Quilliams85/FluidBedRoaster/Documentation/Photos/IMG_2953 Large.jpeg

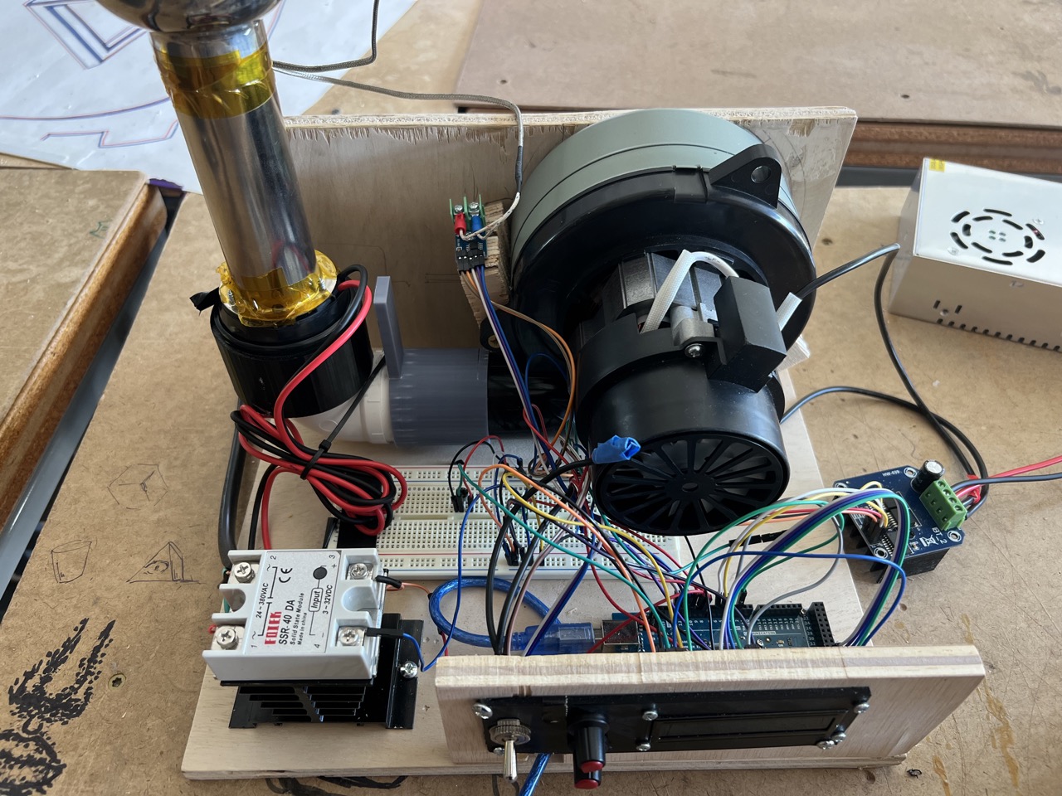
Documentation/Photos/IMG_2953 Large.jpeg
