Quilliams85/FluidBedRoaster/Documentation/Photos/IMG_2955 Large.jpeg

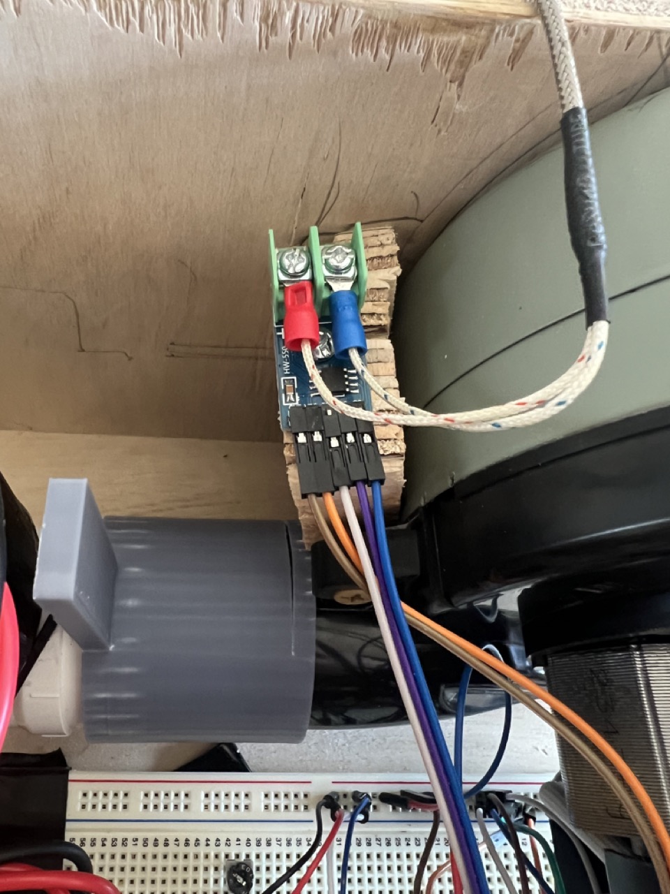
Documentation/Photos/IMG_2955 Large.jpeg
