Quilliams85/FluidBedRoaster/Documentation/Photos/IMG_2956 Large.jpeg

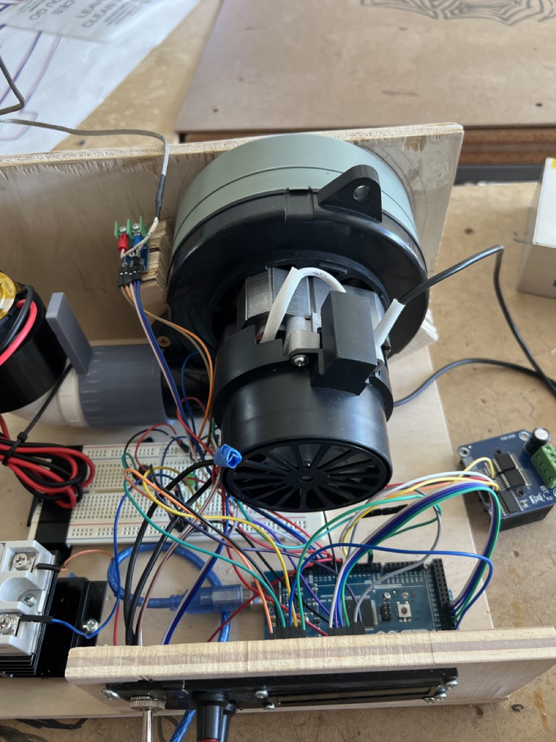
Documentation/Photos/IMG_2956 Large.jpeg
