Quilliams85/FluidBedRoaster/Documentation/Photos/IMG_2957 Large.jpeg

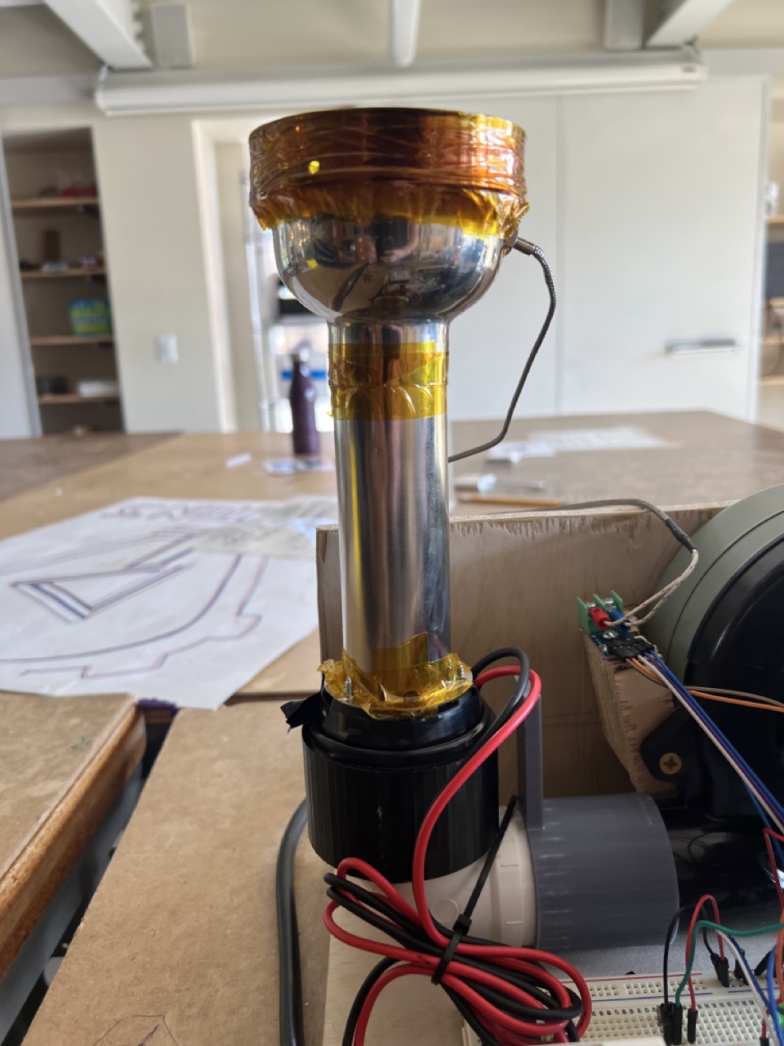
Documentation/Photos/IMG_2957 Large.jpeg
