Quilliams85/FluidBedRoaster/Documentation/Photos/IMG_2958 Large.jpeg

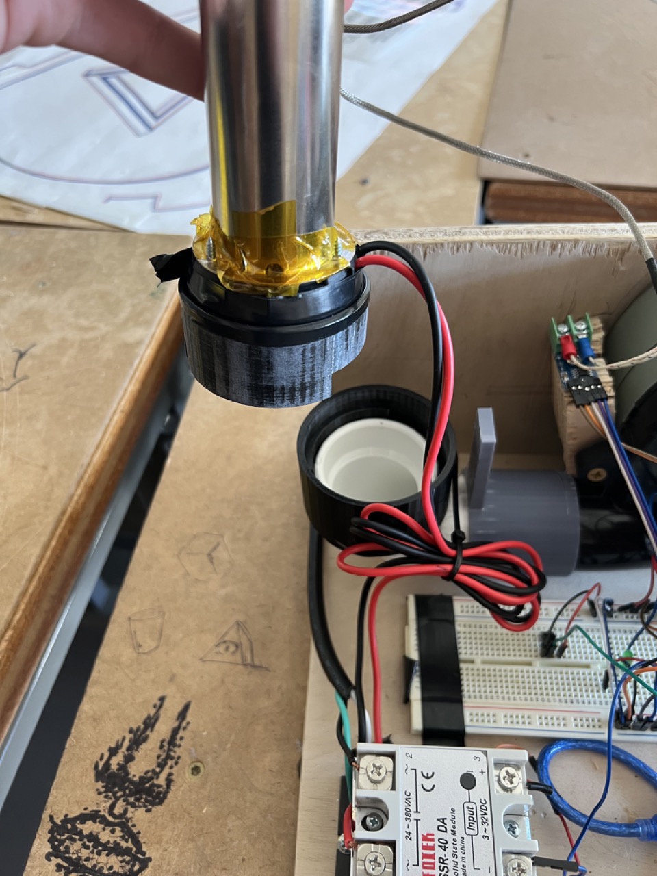
Documentation/Photos/IMG_2958 Large.jpeg
