Quilliams85/FluidBedRoaster/Documentation/Photos/IMG_2959 Large.jpeg

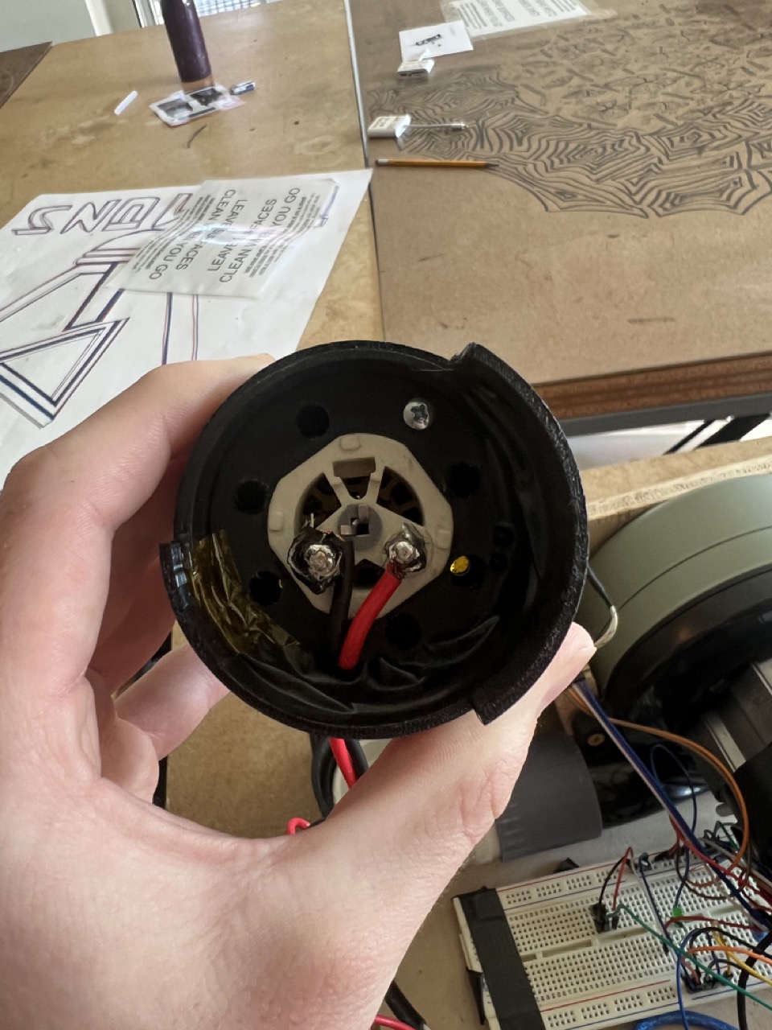
Documentation/Photos/IMG_2959 Large.jpeg
