Quilliams85/FluidBedRoaster/Documentation/Photos/IMG_2960 Large.jpeg

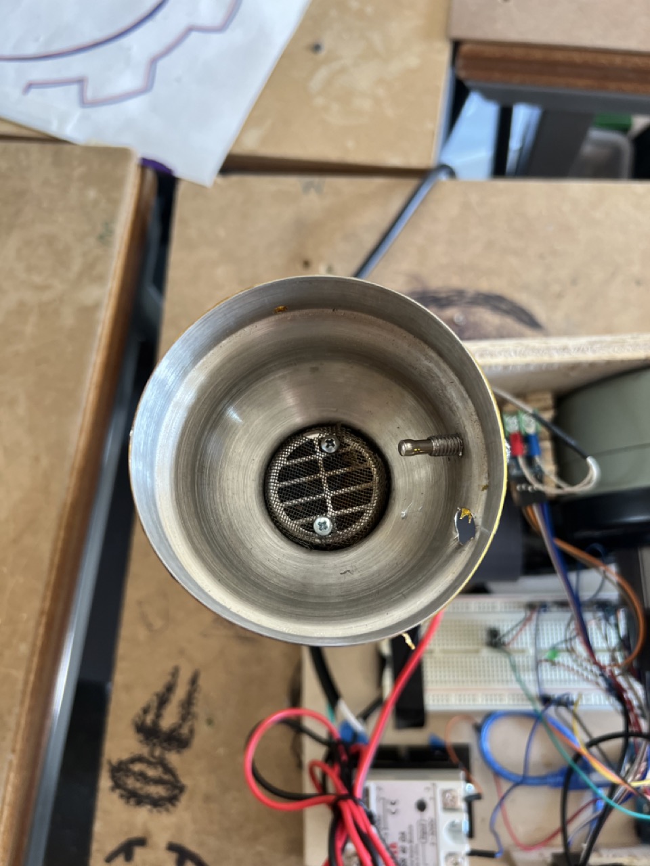
Documentation/Photos/IMG_2960 Large.jpeg
