Quilliams85/FluidBedRoaster/Documentation/Photos/IMG_2963 Large.jpeg

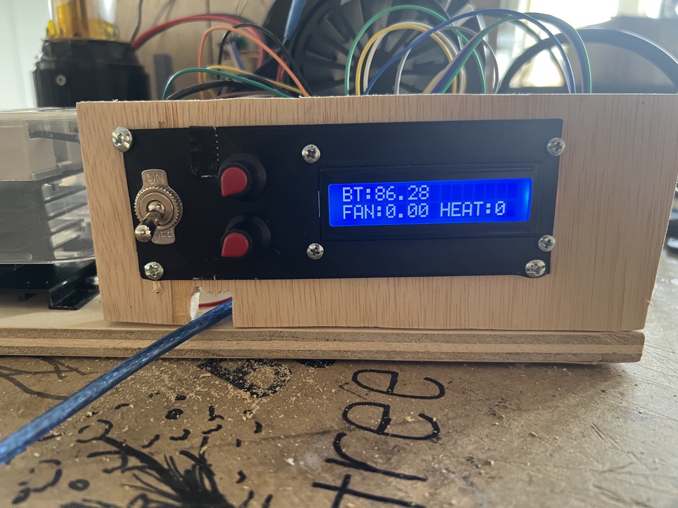
Documentation/Photos/IMG_2963 Large.jpeg
