Quilliams85/FluidBedRoaster/Documentation/Photos/IMG_2964 Large.jpeg

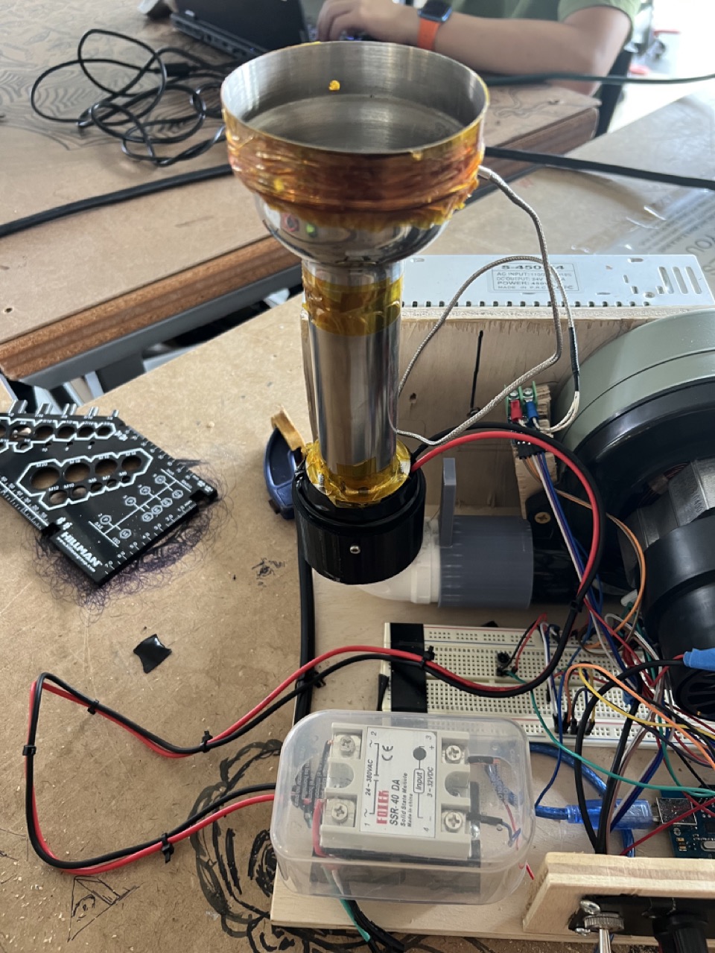
Documentation/Photos/IMG_2964 Large.jpeg
