Quilliams85/FluidBedRoaster/Documentation/Photos/IMG_2965 Large.jpeg

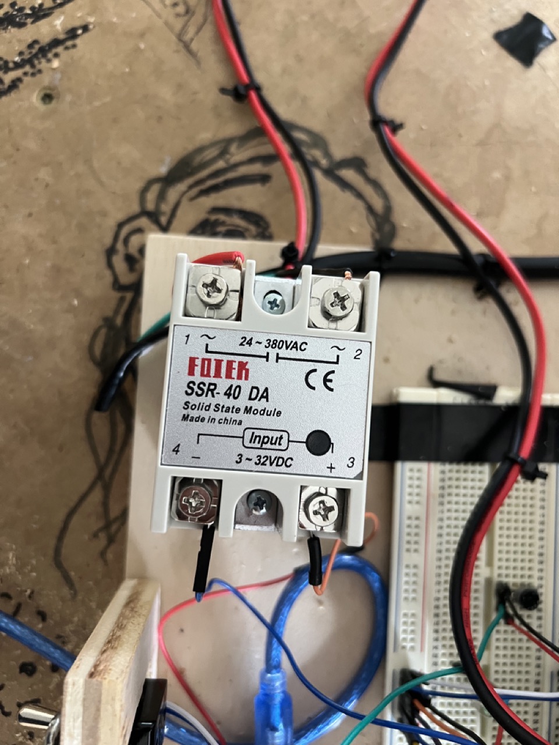
Documentation/Photos/IMG_2965 Large.jpeg
