Quilliams85/FluidBedRoaster/Documentation/Schematics/Fluid Bed Roaster_bb.png

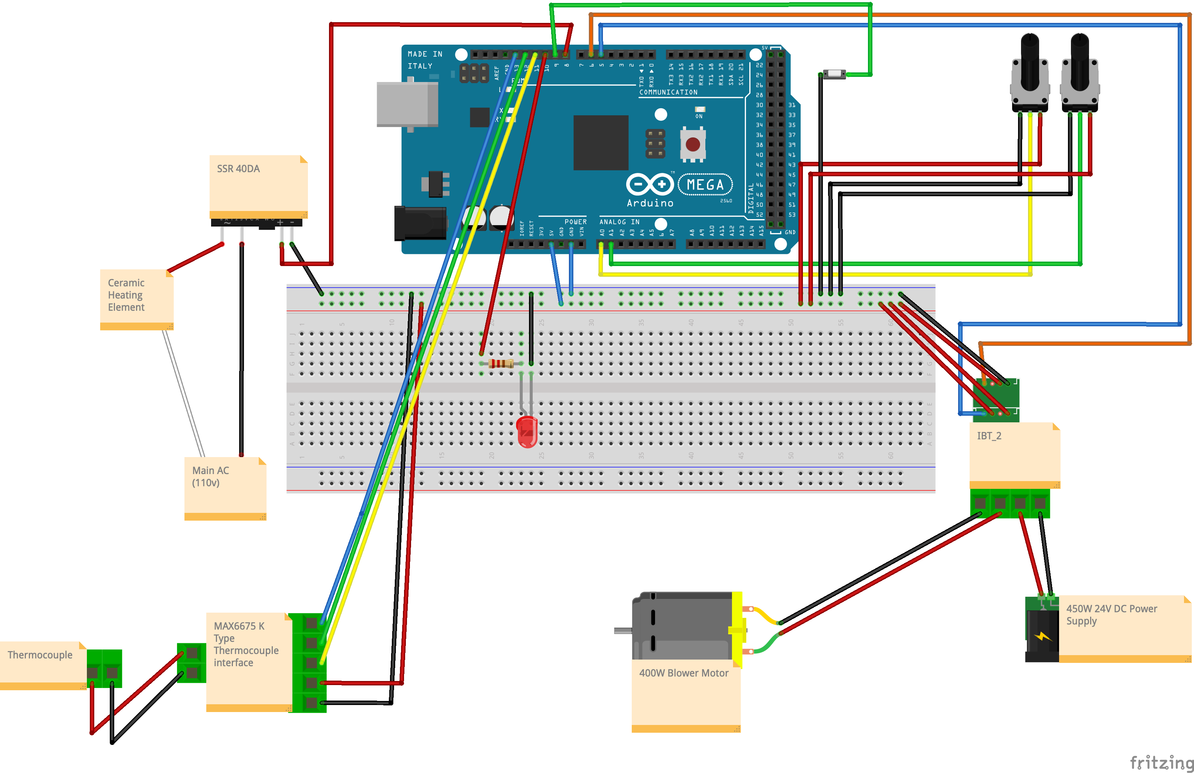
Documentation/Schematics/Fluid Bed Roaster_bb.png
