Quilliams85/FluidBedRoaster/Documentation/build instructions/Bill of Materiasl.csv

Part Name | function | price | link
24V 2 stage vacuum motor | air blower | 75.64 | https://shop.usaclean.com/24v-2-stage-vacuum-motor-tangential-991-1203/?itemId=536834
Ceramic Heating element | heat air | 16.9 | https://www.amazon.com/Professional-Replacement-Resistance-Elements-Diameter/dp/B07N2M5PD7
Cocktail Shaker | roast chamber | 7.99 | https://www.amazon.com/Cocktail-Bartender-Professional-Stainless-Margarita/dp/B0BC9VWBC4?th=1
SSR 40DA | heat switch | 9.99 | https://www.amazon.com/Coliao-24-380V-Thermostat-Temperature-Controller/dp/B09NR5KN8P
24v Power supply | power fan | 30.99 | https://www.amazon.com/inShareplus-Universal-Regulated-Switching-Transformer/dp/B07YYCGCS1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
IBT2 speed controller | control fan speed | 10.99 | https://www.amazon.com/HiLetgo-BTS7960-Driver-Arduino-Current/dp/B00WSN98DC
18 gauge wire | wiring stuff | 6.99 | https://www.amazon.com/Automotive-Flexible-Security-Stranded-Electrical/dp/B0CKR35SX5?th=1
heat tape | assembly/patch gaps | 9.99 | https://www.amazon.com/MEBMIK-Temperature-Resistant-Transfer-Sublimation/dp/B0CQYJJMVG
extension cords | wiring power supply and heat | 9.99 | https://www.amazon.com/Heavy-Extension-Indoor-Outdoor-Listed/dp/B0B3D6Y5W2
heat gun | element housing/element | 18.99 | https://www.amazon.com/Dual-Temperature-Nozzles-122%E1%B5%92F-1022%E1%B5%92F-Wrapping-Stripping/dp/B07QF8QRQ5
borosilicate glass tube | roast chamber | 16.5 | https://www.amazon.com/SUNWO-Borosilicate-Chimney-Hurricane-Holders/dp/B07J41V7JG?th=1
Arduino Mega | microcontroller | 21.99 | https://www.amazon.com/ELEGOO-Compatible-Arduino-Projects-Compliant/dp/B01H4ZLZLQ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
breadboard and jumper wires | wiring | 9.99 | https://www.amazon.com/BOJACK-Values-Solderless-Breadboard-Flexible/dp/B08Y59P6D1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
MAX 6675 thermocouple | BT probe | 7.69 | https://www.amazon.com/gp/product/B01HT871SO/ref=ewc_pr_img_1?smid=A30QSGOJR8LMXA&psc=1
dryer hose | exhaust | 9.99 | https://www.amazon.com/Steelsoft-Flexible-Exhaust-Aluminum-Ducting/dp/B0BXGYRN2P?s=hi
TOTAL |  | 264.62
Additional Parts(optional) | function | price | link
borosilicate glass tube | roast chamber outer tube | 23 | https://www.amazon.com/SUNWO-Borosilicate-Chimney-Hurricane-Holders/dp/B07J3XNPTX?th=1
potentiometers | heat fan controls | 8.66 | https://www.amazon.com/Taiss-Potentiometer-potentiometers-Assortment-Terminals/dp/B0B3126K2M
LCD display | display temps ect. | 11.99 | https://www.amazon.com/Hosyond-Display-Module-Arduino-Raspberry/dp/B0BWTFN9WF
MAX 6675 thermocouple #2 | ET probe | 7.69 | https://www.amazon.com/gp/product/B01HT871SO/ref=ewc_pr_img_1?smid=A30QSGOJR8LMXA&psc=1
Cyclone dust collector | chaff seperator | 25.99 | https://www.amazon.com/gp/product/B0CJBDHCQY/ref=ewc_pr_img_3?smid=A1J9VXUDDDTNDV&psc=1
2x1 adapter | step down exhaust | 14.99 | https://www.amazon.com/gp/product/B071YYP1QL/ref=ewc_pr_img_2?smid=A9R8MBSY7L1UV&psc=1
4x2 adapter | step down exhaust | 14.59 | https://www.amazon.com/gp/product/B0B7448NF3/ref=ewc_pr_img_3?smid=AIX60DP73AM0L&psc=1
aluminum tape | taping gaps | 6.99 | https://www.amazon.com/Aluminum-Ductwork-Temperature-Insulation-Adhesive/dp/B0B6NDFXPN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
TOTAL w/extras |  | 378.52
