Quilliams85/FluidBedRoaster/Documentation/Roasts/Roast Ranking.pdf

# Roast Ranking

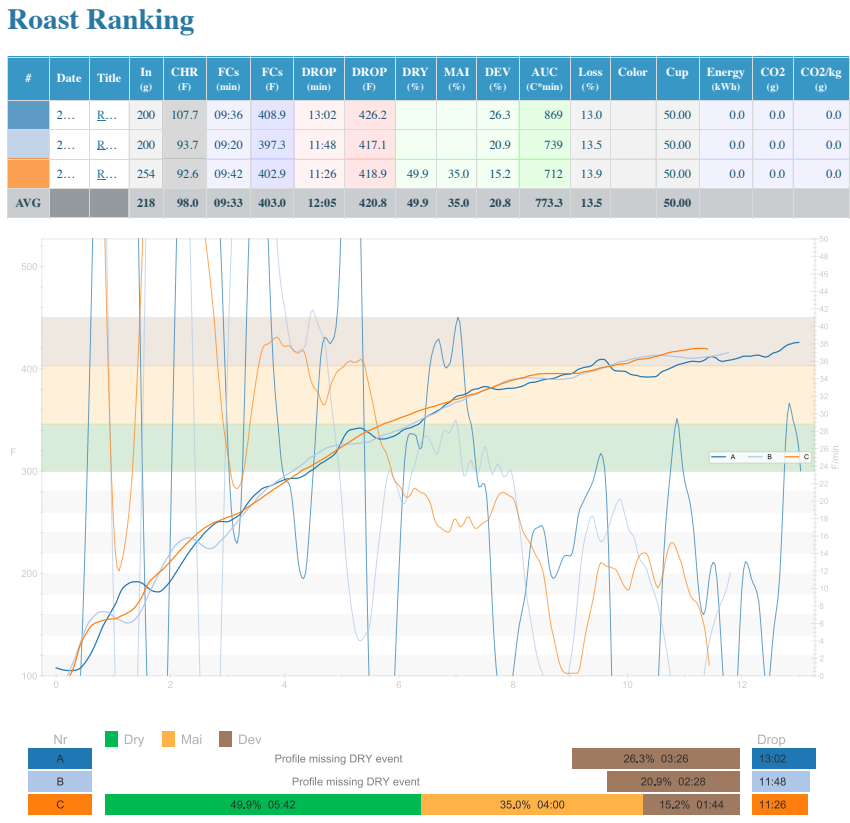
[picture p13: page 1]

# | Date | Title | In (g) | CHR (F) | FCs (min) | FCs (F) | DROP (min) | DROP (F) | DRY (%) | MAI (%) | DEV (%) | AUC (C*min) | Loss (%) | Color | Cup | Energy (kWh) | CO2 (g) | CO2/kg (g)

AVG | | | 218 | 98.0 | 09:33 | 403.0 | 12:05 | 420.8 | 49.9 | 35.0 | 20.8 | 773.3 | 13.5 | | 50.00
