Quilliams85/FluidBedRoaster/(commit log)

2024-10-20 Add files via upload
    Add bill of materials
    [Bill of Materiasl.csv]
2024-10-20 Update Folder Structure
    move stuff around to organize files. Added schematics
    [Bill of Materiasl.csv]
2024-10-20 Add arduino code
    added arduino main code
2024-10-25 Update Arduino Code
    include LCD programming
    minor changes to controls
